haxeko/h2-soil-sensor/hardware/docs/drc_report.txt

** Drc report for /home/user/h2-soil-sensor/hardware/h2-soil-sensor.kicad_pcb **
** Created on 2026-11-12 06:37:23 **

** Found 0 DRC violations **

** Found 0 unconnected pads **

** Found 0 Footprint errors **

** End of Report **
