haxeko/h2-soil-sensor/hardware/docs/render_bottom.png

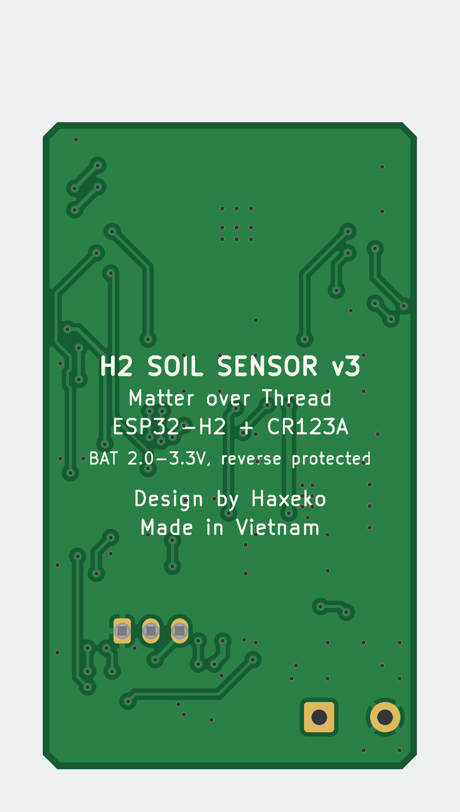
hardware/docs/render_bottom.png
