haxeko/h2-soil-sensor/hardware/docs/render_top.png

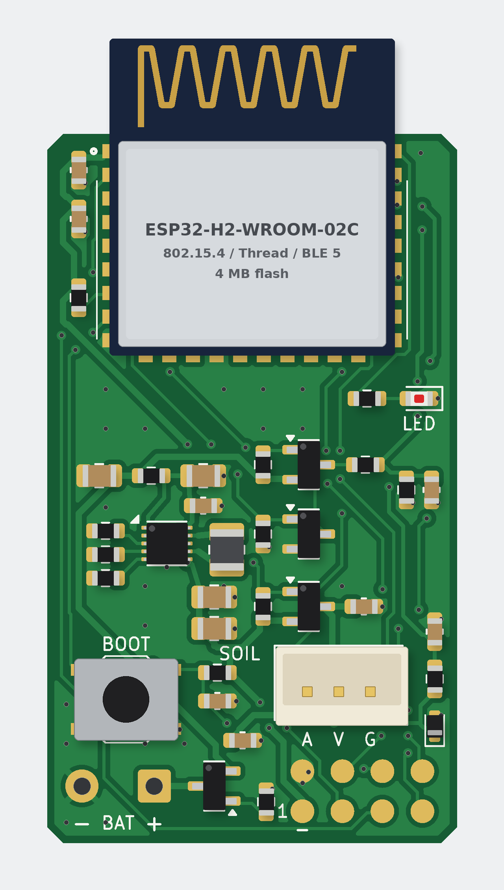
hardware/docs/render_top.png
