haxeko/h2-soil-sensor/hardware/fab/h2-soil-sensor_BOM_JLCPCB.csv

Comment | Designator | Footprint | LCSC Part # | MPN | Manufacturer | Qty
47uF 6.3V | C1 | C_0805_2012Metric | C16780 | CL21A476MQYNNNE | Samsung | 1
10uF 25V | C2 | C_0805_2012Metric | C15850 | CL21A106KAYNNNE | Samsung | 1
100nF | C3,C9,C21 | C_0603_1608Metric | C14663 | CC0603KRX7R9BB104 | YAGEO | 3
22uF 25V | C4,C5 | C_0805_2012Metric | C45783 | CL21A226MAQNNNE | Samsung | 2
10nF | C6,C13 | C_0603_1608Metric | C1589 | CL10B103KB8NNNC | Samsung | 2
1uF | C7,C14 | C_0603_1608Metric | C15849 | CL10A105KB8NNNC | Samsung | 2
10uF 10V | C8 | C_0603_1608Metric | C19702 | CL10A106KP8NNNC | Samsung | 1
RED | D2 | LED_0603_1608Metric | C2286 | KT-0603R | Hubei KENTO | 1
ESD 3.3V | D3 | D_SOD-523 | C136161 | LESD5Z3.3T1G | LRC | 1
2.2uH | L1 | L_1008_2520Metric | C404804 | TFM252012ALMA2R2MTAA | TDK | 1
AO3415A | Q1 | SOT-23 | C133233 | AO3415A | AOS | 1
AO3401A | Q2,Q4 | SOT-23 | C15127 | AO3401A | AOS | 2
2N7002 | Q3 | SOT-23 | C8545 | 2N7002 | CJ | 1
100k | R1,R6,R7,R8,R9 | R_0603_1608Metric | C25803 | 0603WAF1003T5E | UNI-ROYAL | 5
36.5k | R2 | R_0603_1608Metric | C23029 | 0603WAF3652T5E | UNI-ROYAL | 1
0R | R3,R10 | R_0603_1608Metric | C21189 | 0603WAF0000T5E | UNI-ROYAL | 2
16.2k | R4 | R_0603_1608Metric | C22885 | 0603WAF1622T5E | UNI-ROYAL | 1
1M | R5 | R_0603_1608Metric | C22935 | 0603WAF1004T5E | UNI-ROYAL | 1
10k | R11,R21 | R_0603_1608Metric | C25804 | 0603WAF1002T5E | UNI-ROYAL | 2
1k | R12,R22 | R_0603_1608Metric | C21190 | 0603WAF1001T5E | UNI-ROYAL | 2
BOOT/USER | SW1 | SW_Push_1P1T_XKB_TS-1187A | C318884 | TS-1187A-B-A-B | XKB | 1
TPS63900DSKR | U1 | WSON-10-1EP_2.5x2.5mm_P0.5mm_EP1.2x2mm_ThermalVias_0.3mm | C1518762 | TPS63900DSKR | Texas Instruments | 1
