haxeko/h2-soil-sensor/hardware/fab/h2-soil-sensor_not_assembled.csv

Designator | Value | Reason
J1 | PROG | khong lap (pad/lo/test point)
J3 | BAT (pads) | khong lap (pad/lo/test point)
J4 | SOIL (PH2.0) | THT - han tay (C131339)
U2 | ESP32-H2-WROOM-02C-H4S | module ESP32-H2 - han tay / dat rieng
