haxeko/h2-soil-sensor/hardware/docs/schematic.pdf

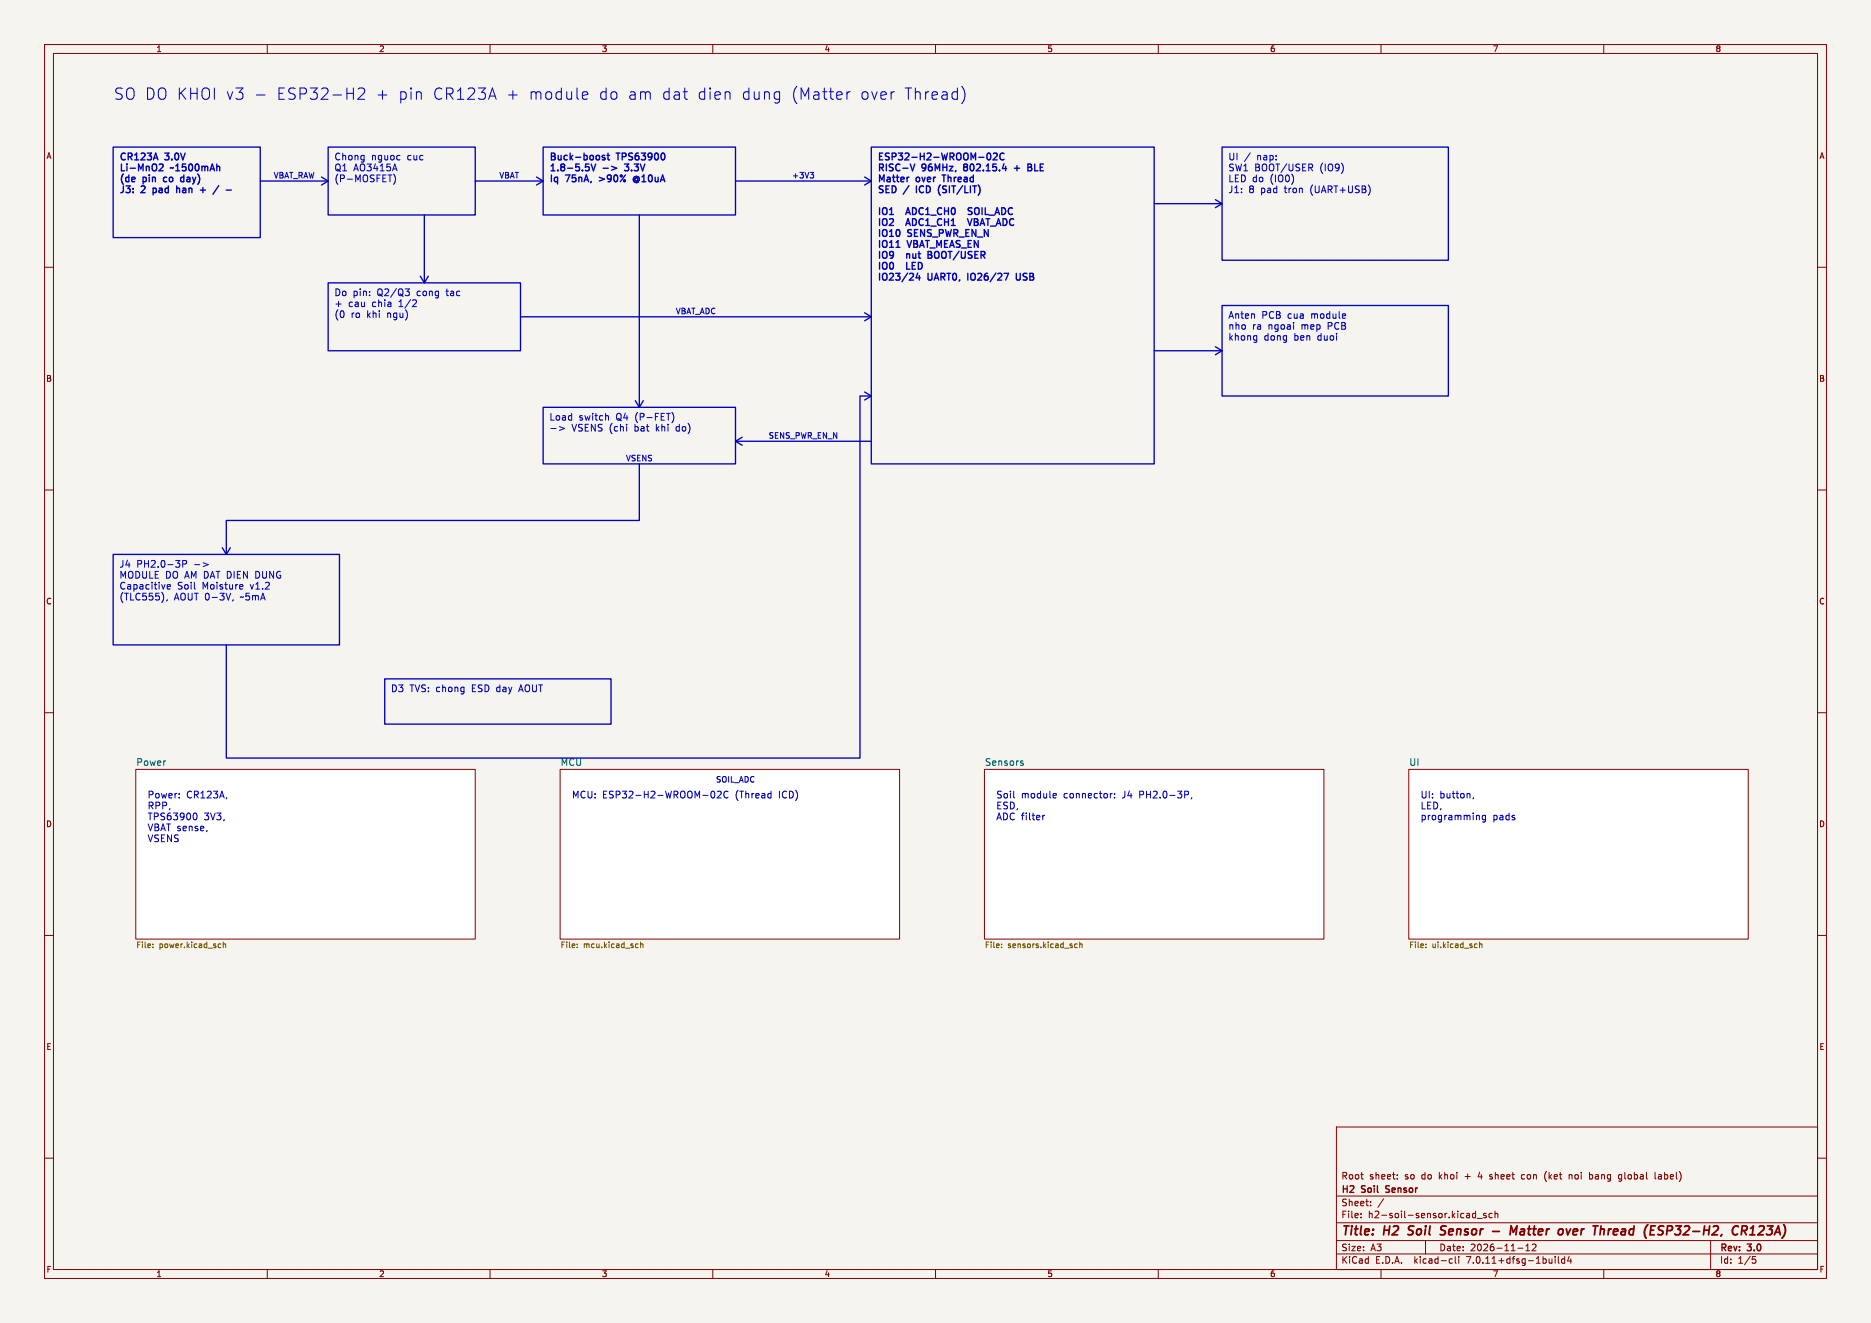
[picture p6: page 1]

UI / nap: SW1 BOOT/USER (IO9) LED do (IO0) J1: 8 pad tron (UART+USB) Anten PCB cua module

Do pin: Q2/Q3 cong tac + cau chia 1/2

nho ra ngoai mep PCB
khong dong ben duoi

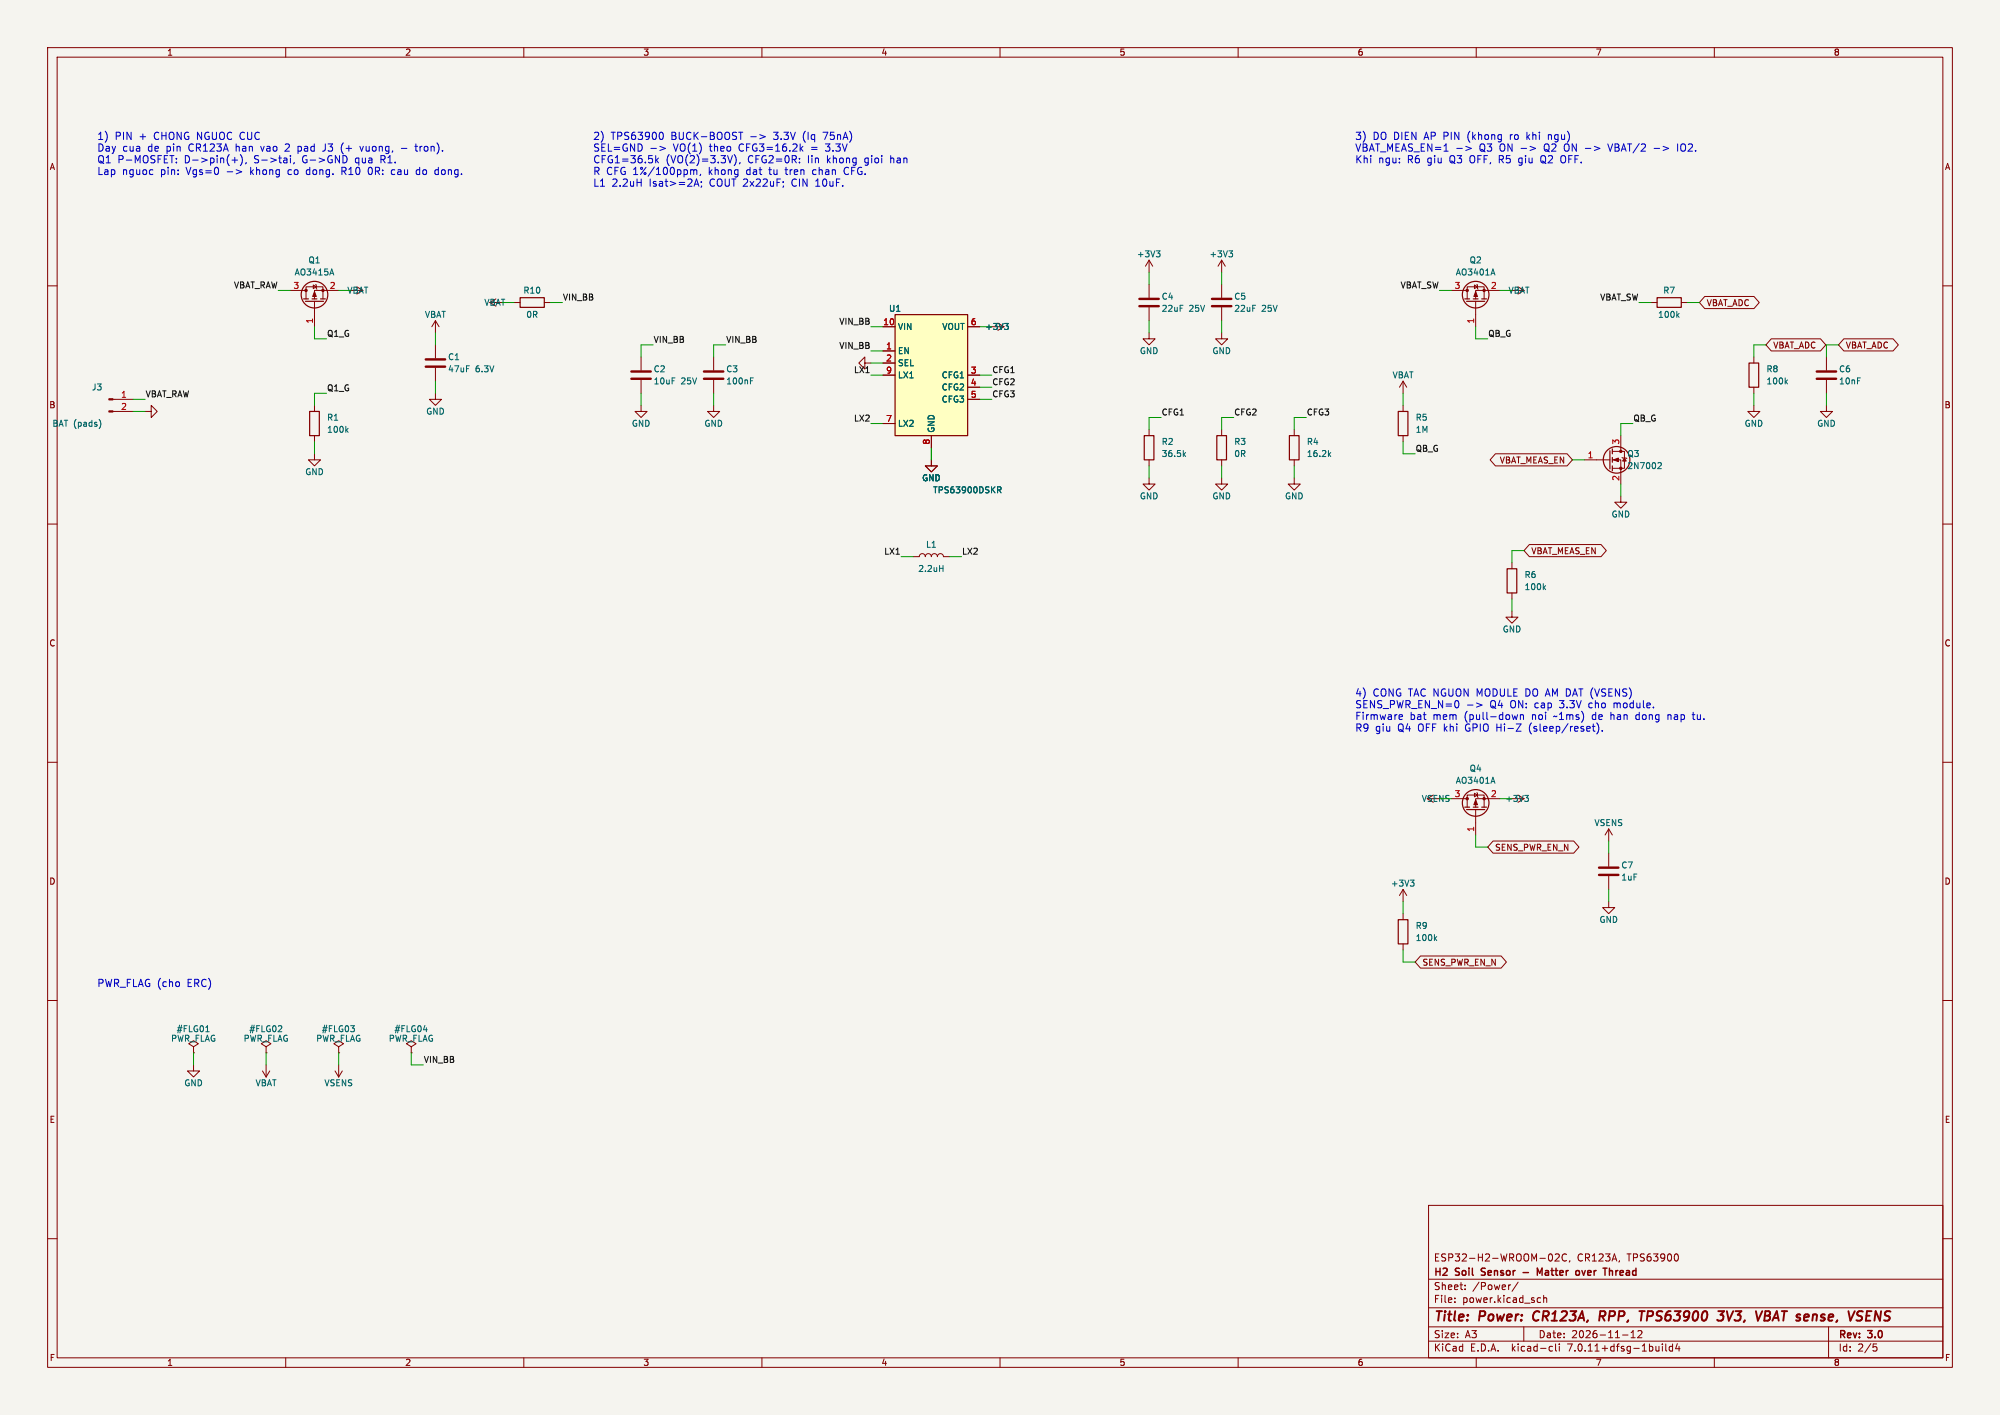
[picture p7: page 2]

Day cua de pin CR123A han vao 2 pad J3 (+ vuong, - tron).

3) DO DIEN AP PIN (khong ro khi ngu)

4) CONG TAC NGUON MODULE DO AM DAT (VSENS)

Id: 2/5 Title: Power: CR123A, RPP, TPS63900 3V3, VBAT sense, VSENS

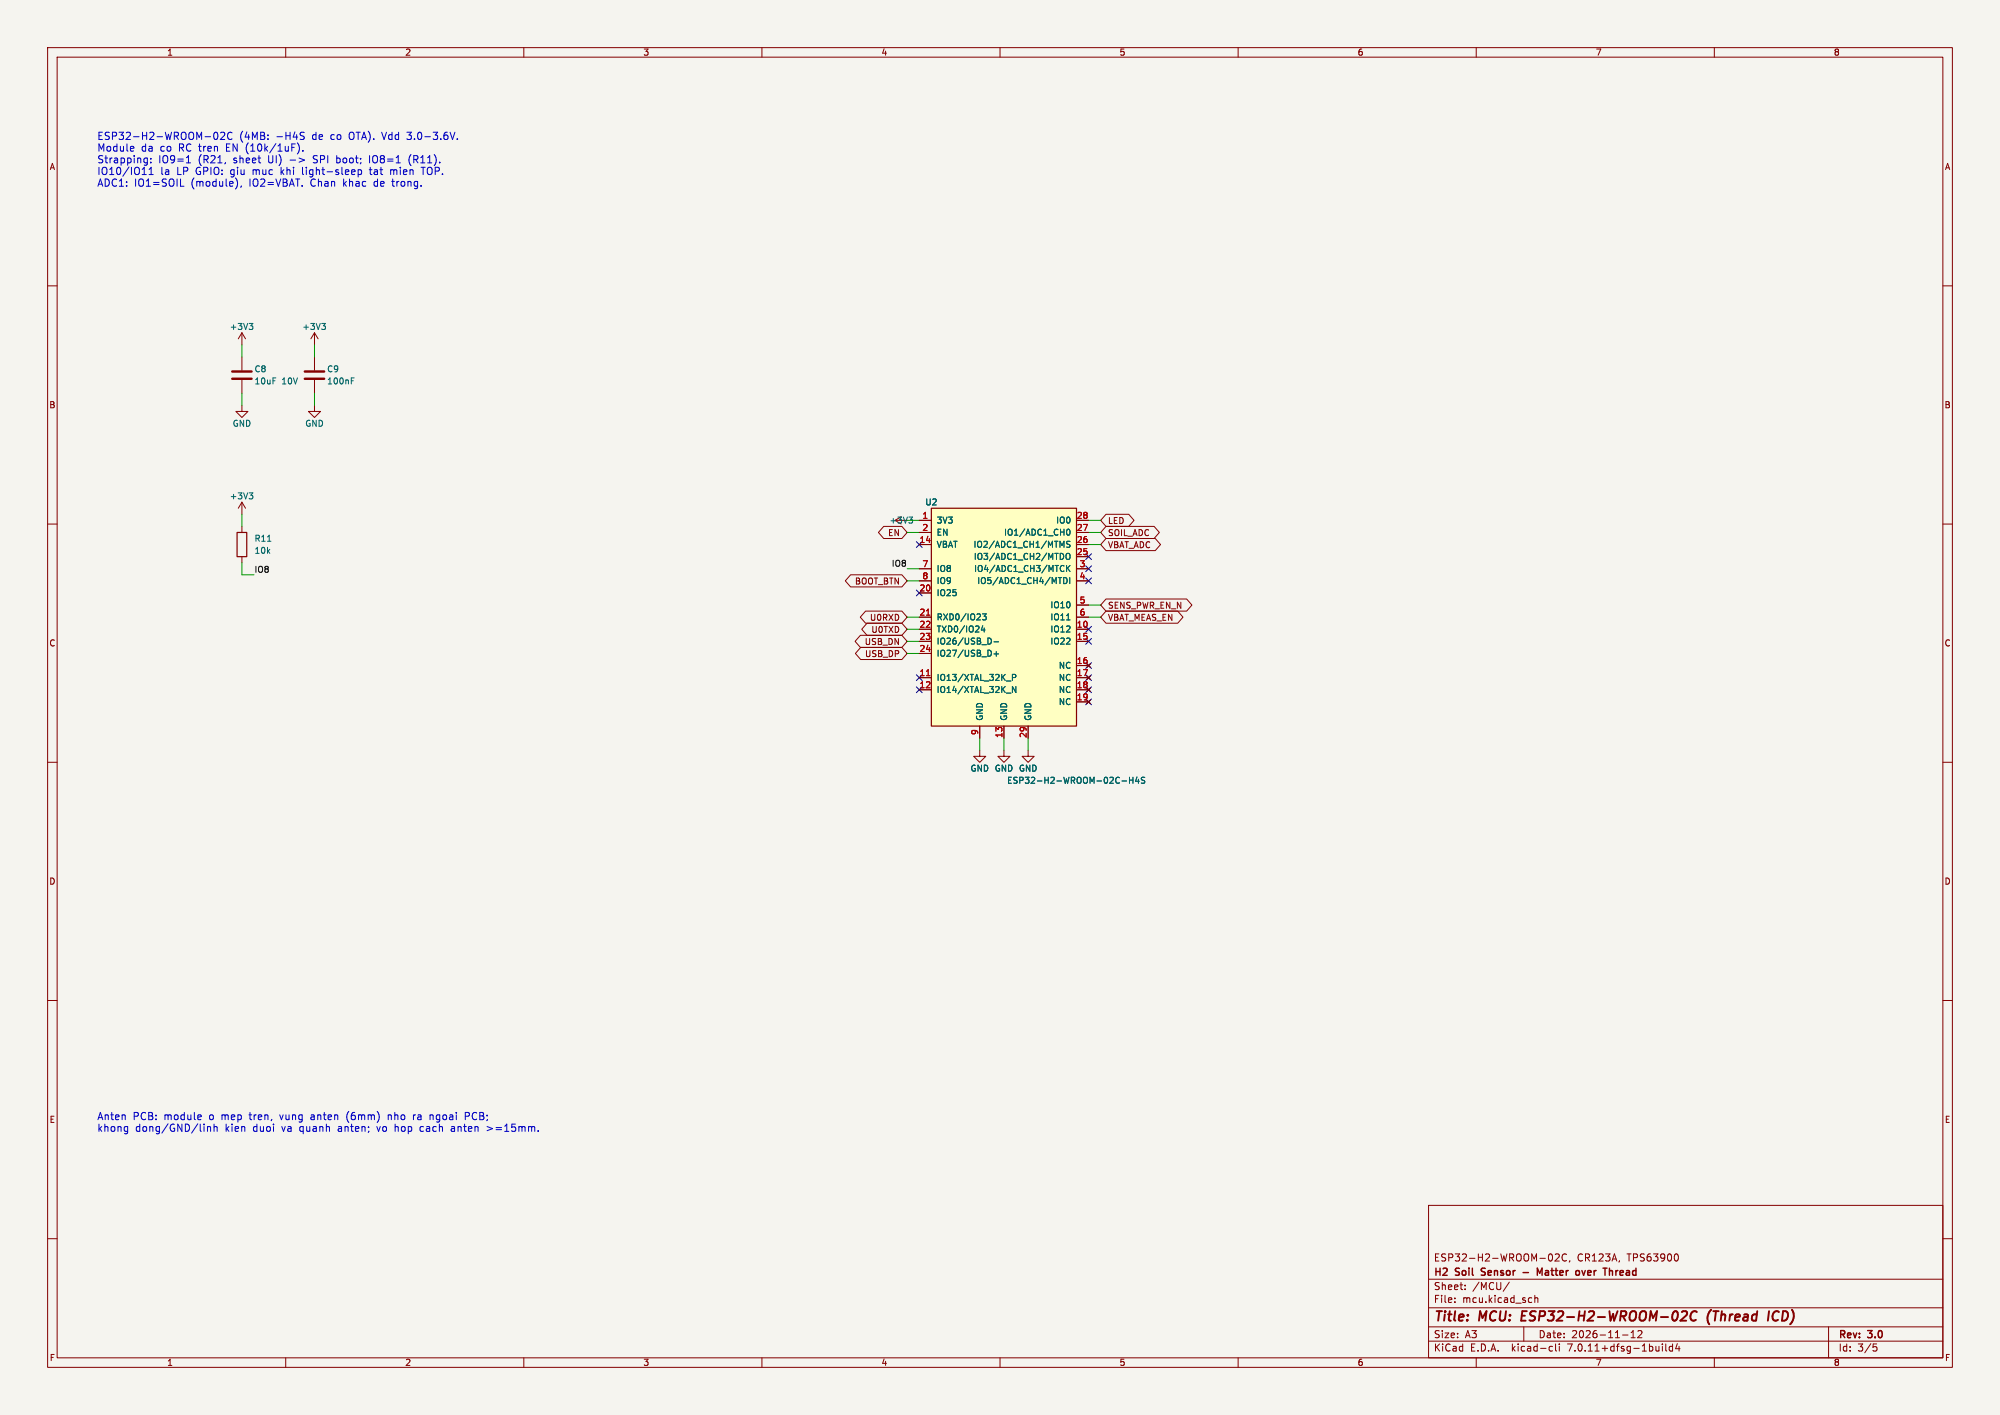
[picture p8: page 3]

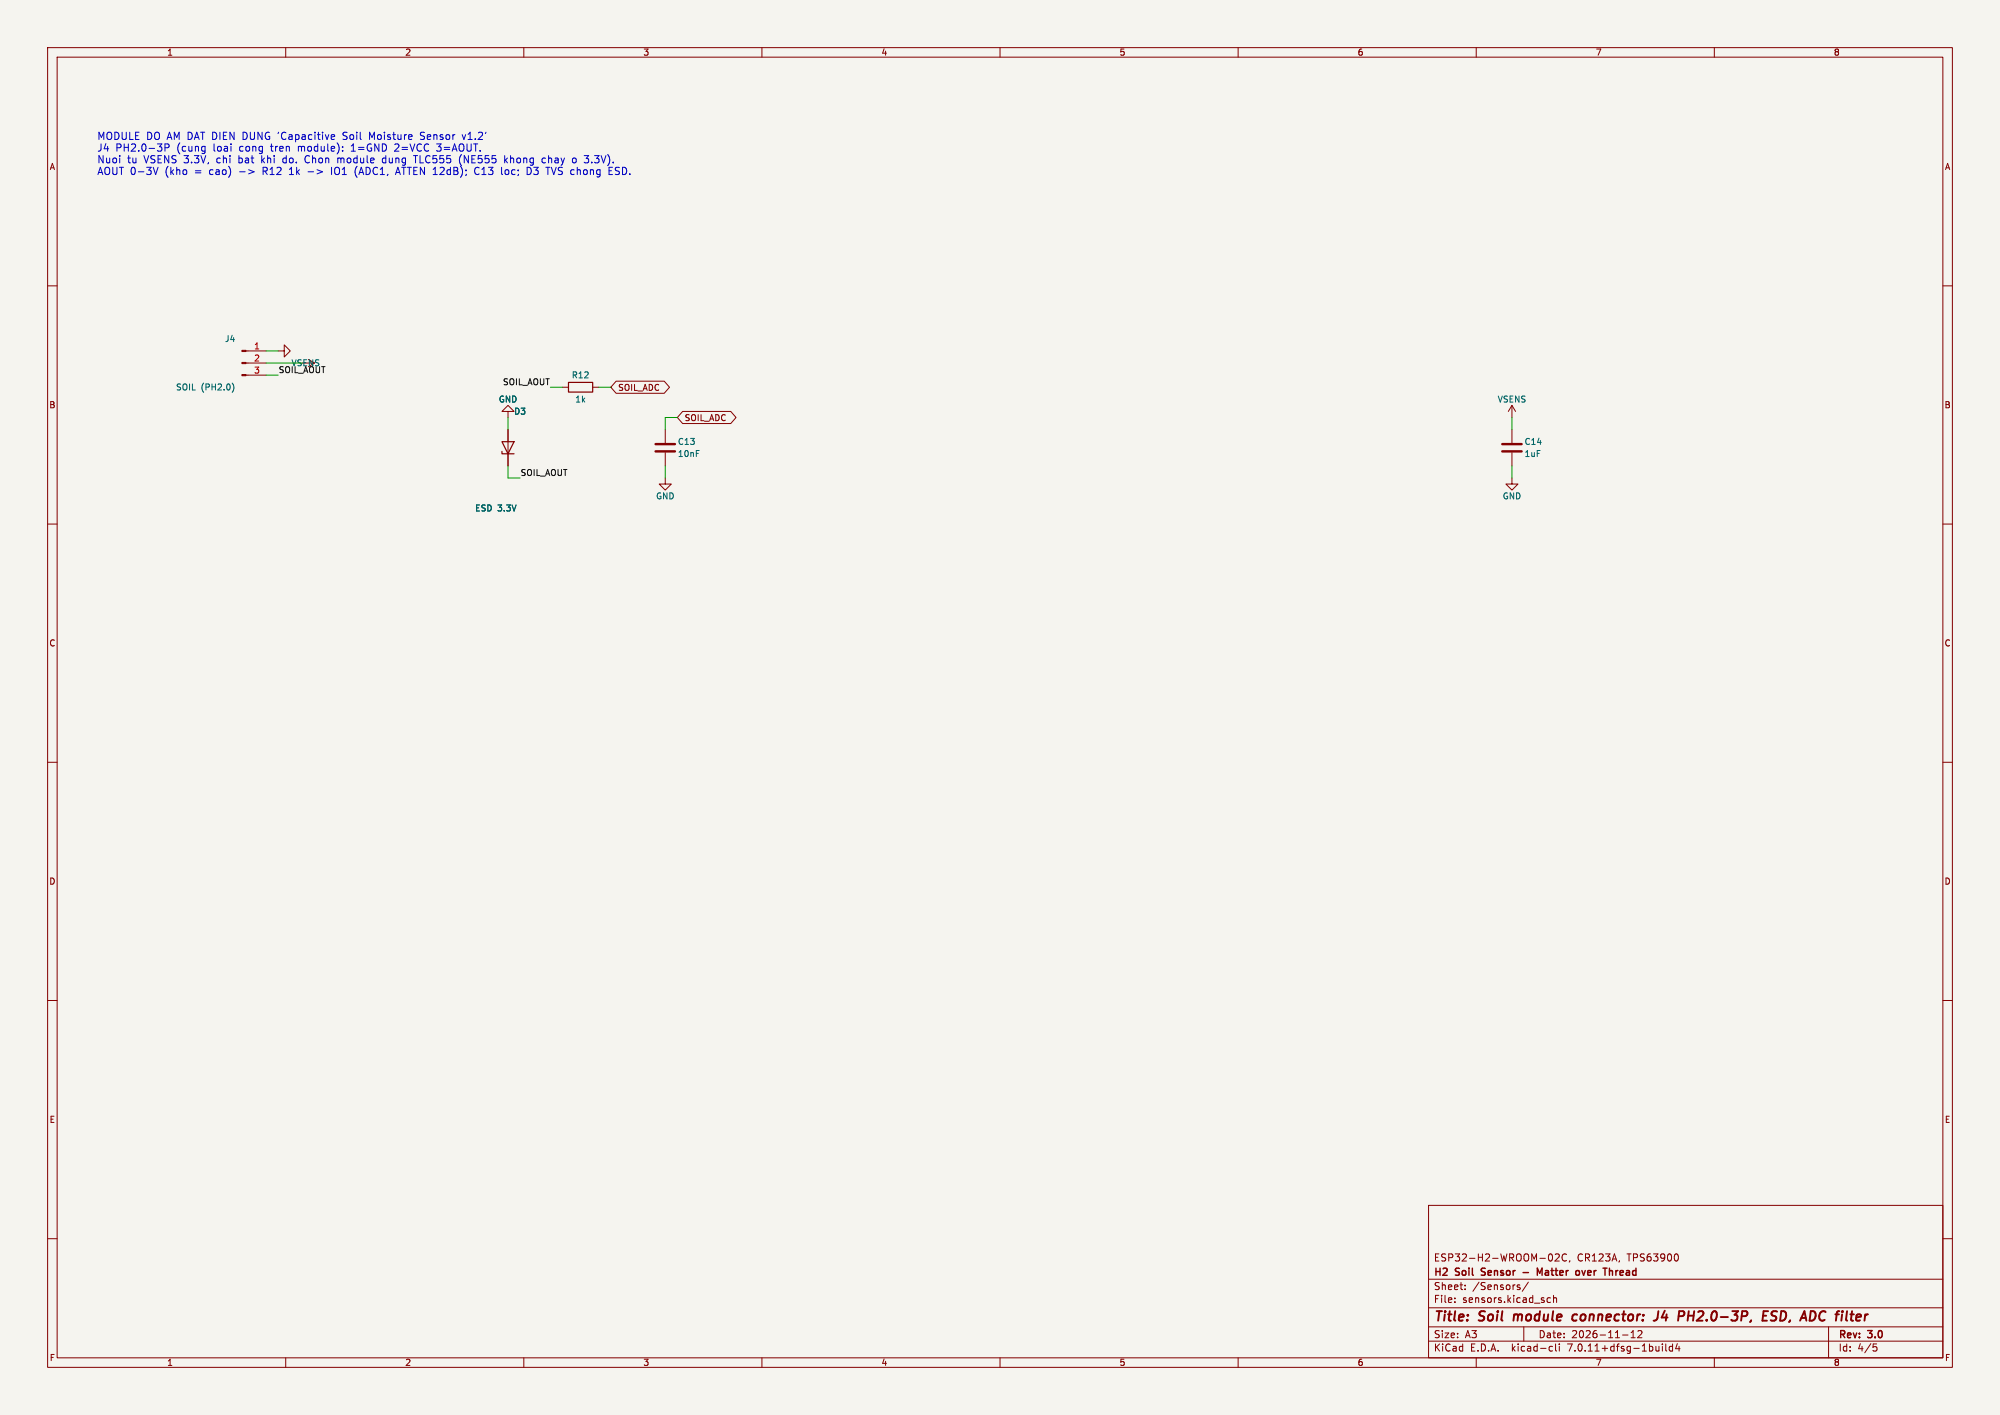
[picture p9: page 4]

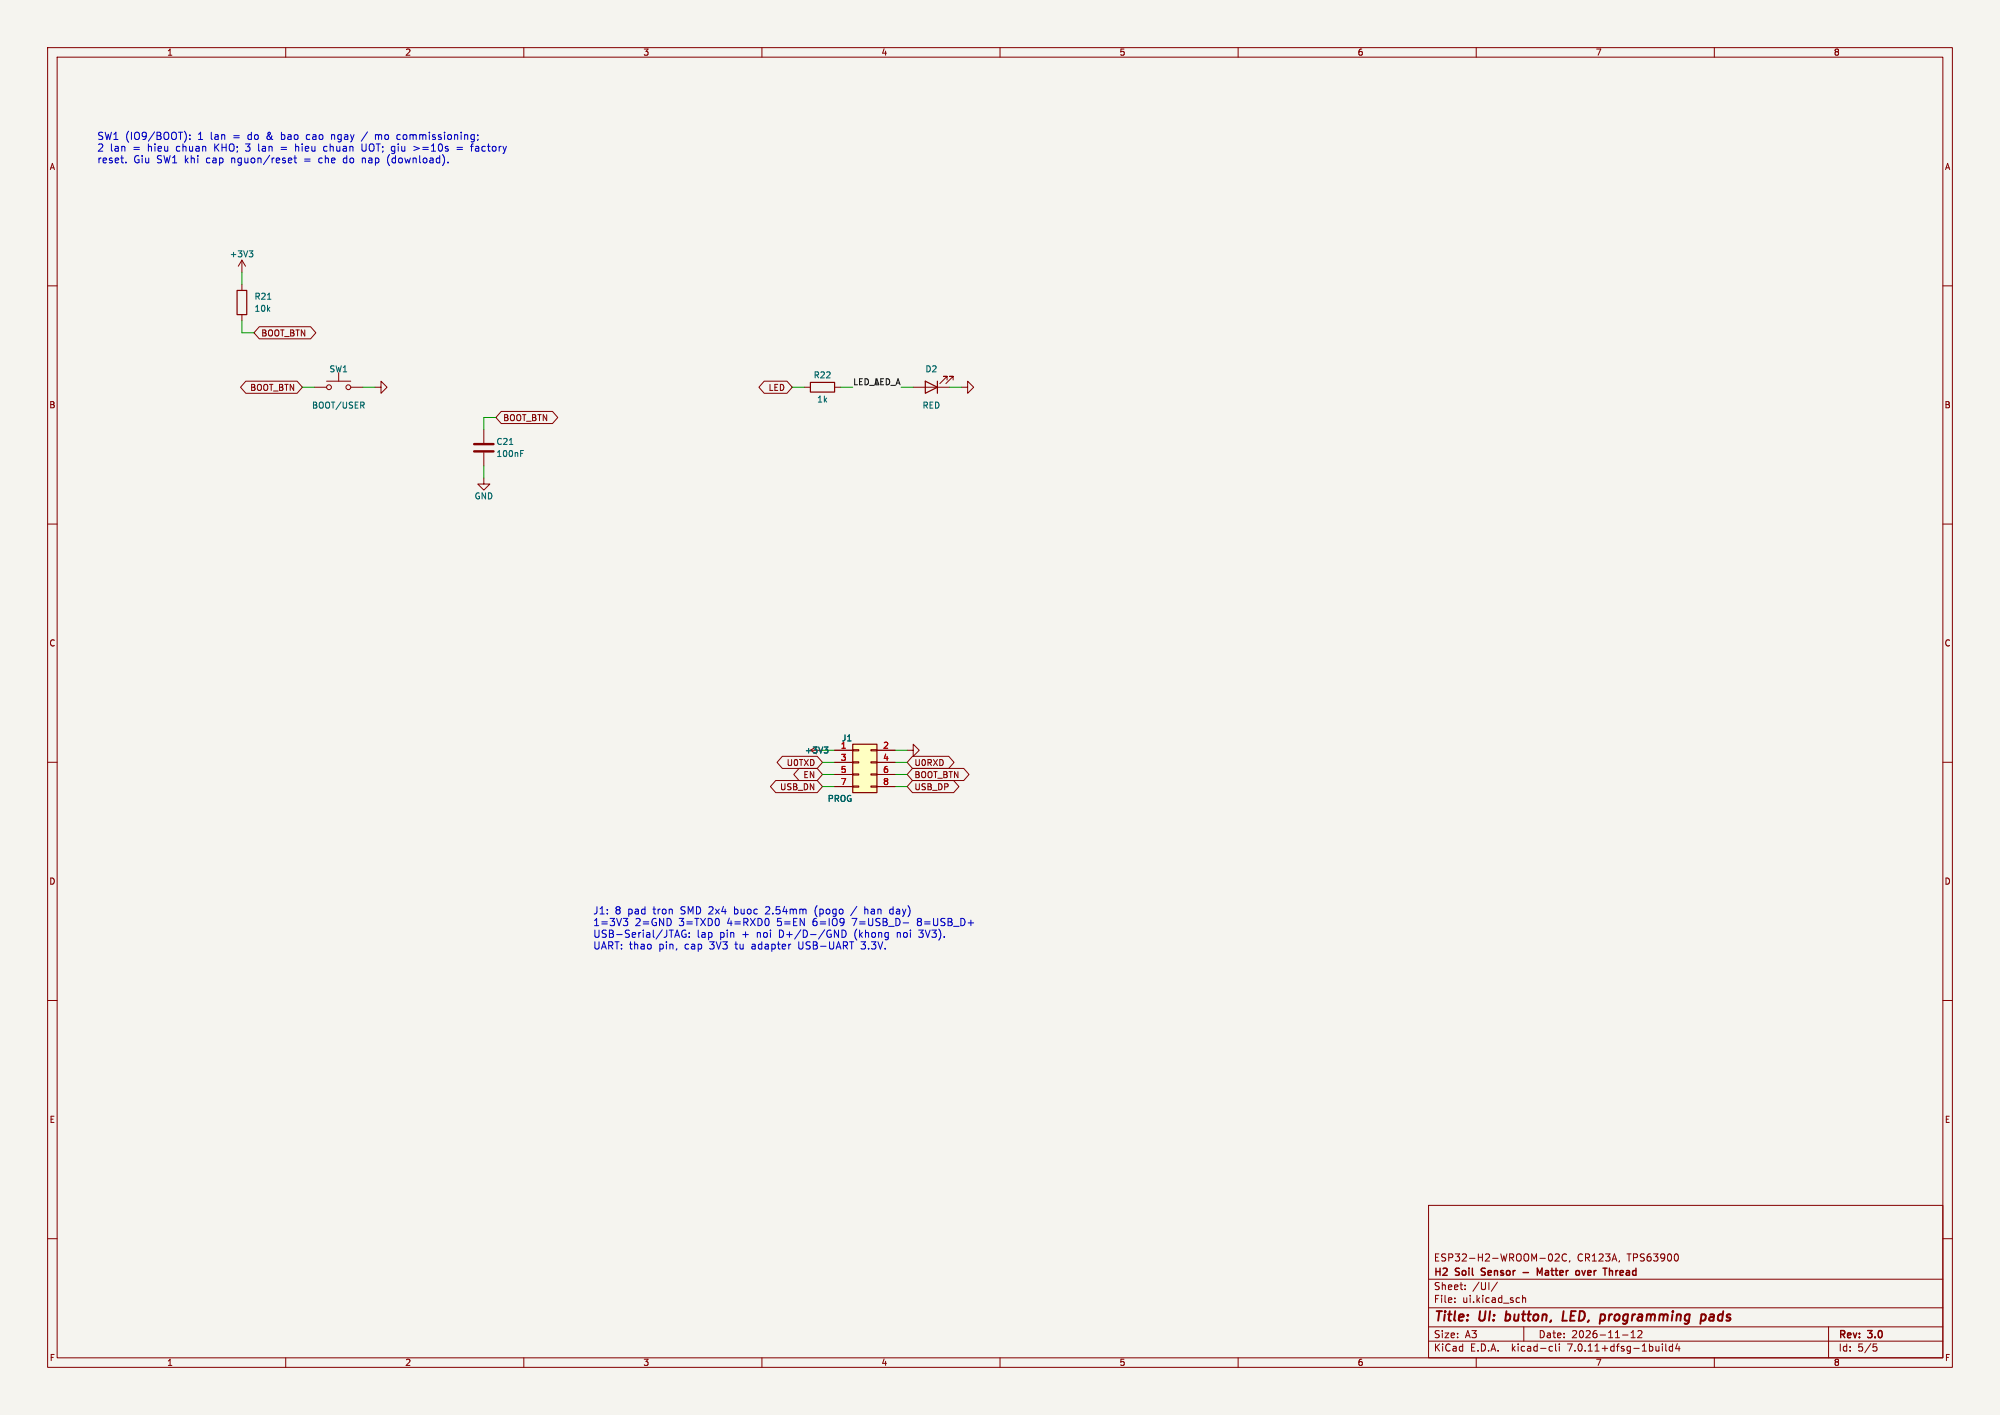
[picture p10: page 5]

Id: 5/5 Title: UI: button, LED, programming pads
