haxeko/h2-soil-sensor/hardware/docs/assembly_top.pdf

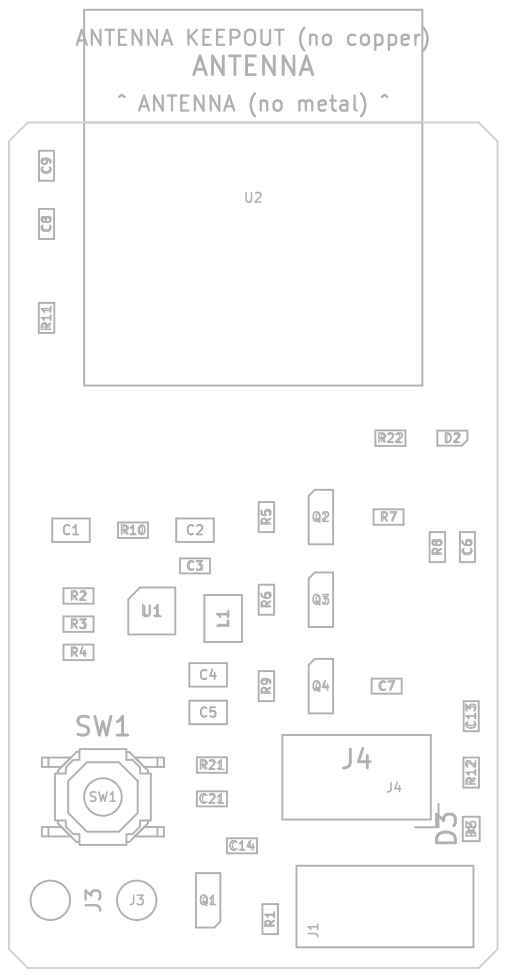
[picture p11: page 1]
