haxeko/h2-soil-sensor/hardware/docs/pcb_bottom.pdf

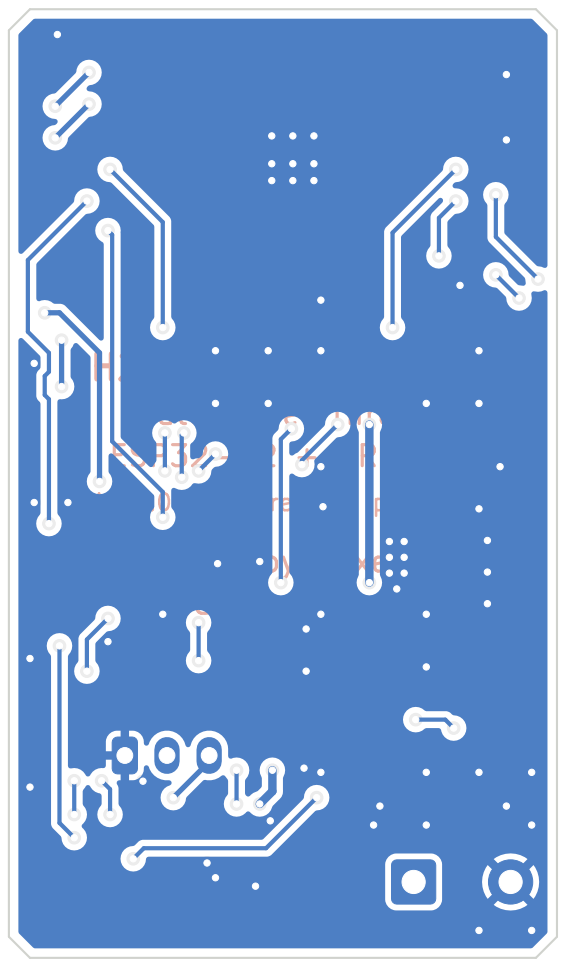
[picture p12: page 1]
