haxeko/h2-soil-sensor/hardware/docs/pcb_top.pdf

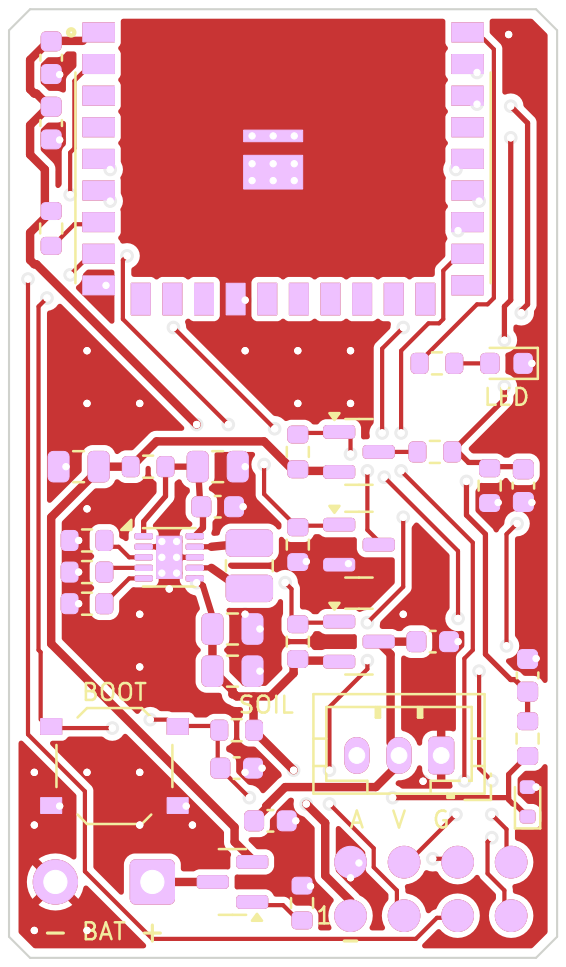
[picture p13: page 1]
