haxeko/h2-soil-sensor/hardware/h2-soil-sensor.kicad_pcb

## KiCad design hardware/h2-soil-sensor.kicad_pcb (2026-11-12)

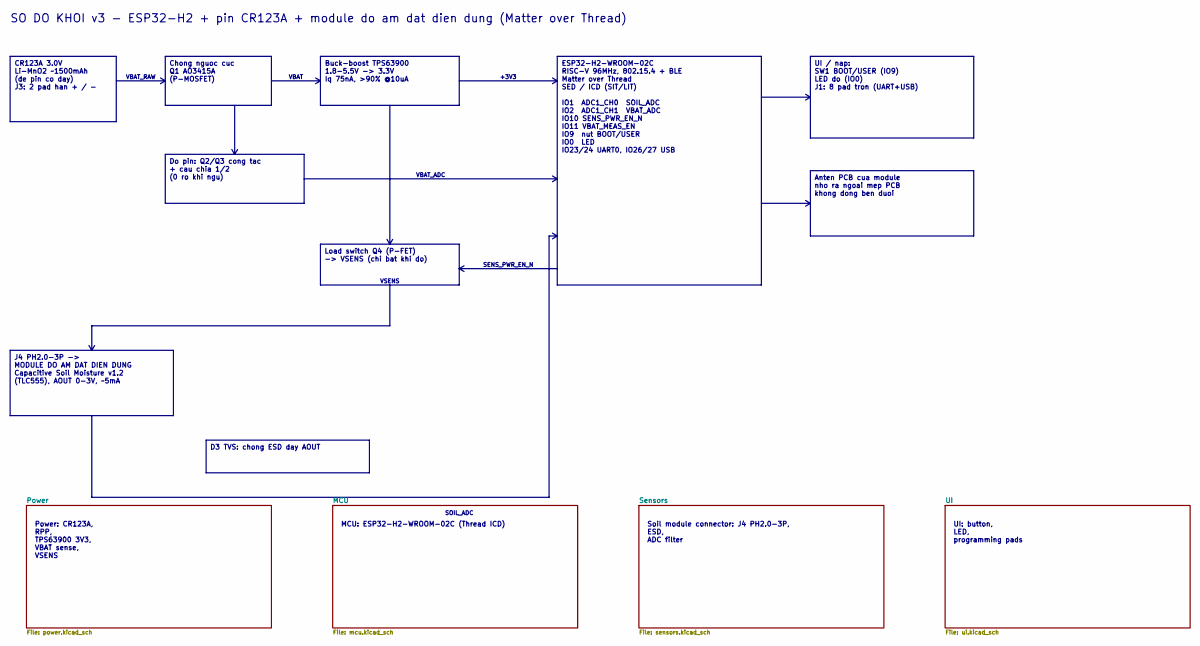
[picture p14: schematic h2-soil-sensor.kicad_sch, H2 Soil Sensor - Matter over Thread (ESP32-H2, CR123A)]

Notes on the sheet:
Power: CR123A, RPP, TPS63900 3V3, VBAT sense, VSENS
MCU: ESP32-H2-WROOM-02C (Thread ICD)
Soil module connector: J4 PH2.0-3P, ESD, ADC filter
UI: button, LED, programming pads
SO DO KHOI v3 - ESP32-H2 + pin CR123A + module do am dat dien dung (Matter over Thread)
CR123A 3.0V Li-MnO2 ~1500mAh (de pin co day) J3: 2 pad han + / -
Chong nguoc cuc Q1 AO3415A (P-MOSFET)
Buck-boost TPS63900 1.8-5.5V -> 3.3V Iq 75nA, >90% @10uA
ESP32-H2-WROOM-02C RISC-V 96MHz, 802.15.4 + BLE Matter over Thread SED / ICD (SIT/LIT) IO1 ADC1_CH0 SOIL_ADC IO2 ADC1_CH1 VBAT_ADC IO10 SENS_PWR_EN_N IO11 VBAT_MEAS_EN IO9 nut BOOT/USER IO0 LED IO23/24 UART0, IO26/27 USB
Do pin: Q2/Q3 cong tac + cau chia 1/2 (0 ro khi ngu)
Load switch Q4 (P-FET) -> VSENS (chi bat khi do)
J4 PH2.0-3P -> MODULE DO AM DAT DIEN DUNG Capacitive Soil Moisture v1.2 (TLC555), AOUT 0-3V, ~5mA
D3 TVS: chong ESD day AOUT
UI / nap: SW1 BOOT/USER (IO9) LED do (IO0) J1: 8 pad tron (UART+USB)
Anten PCB cua module nho ra ngoai mep PCB khong dong ben duoi
VBAT_RAW
VBAT
+3V3
VBAT_ADC
SENS_PWR_EN_N
VSENS
SOIL_ADC

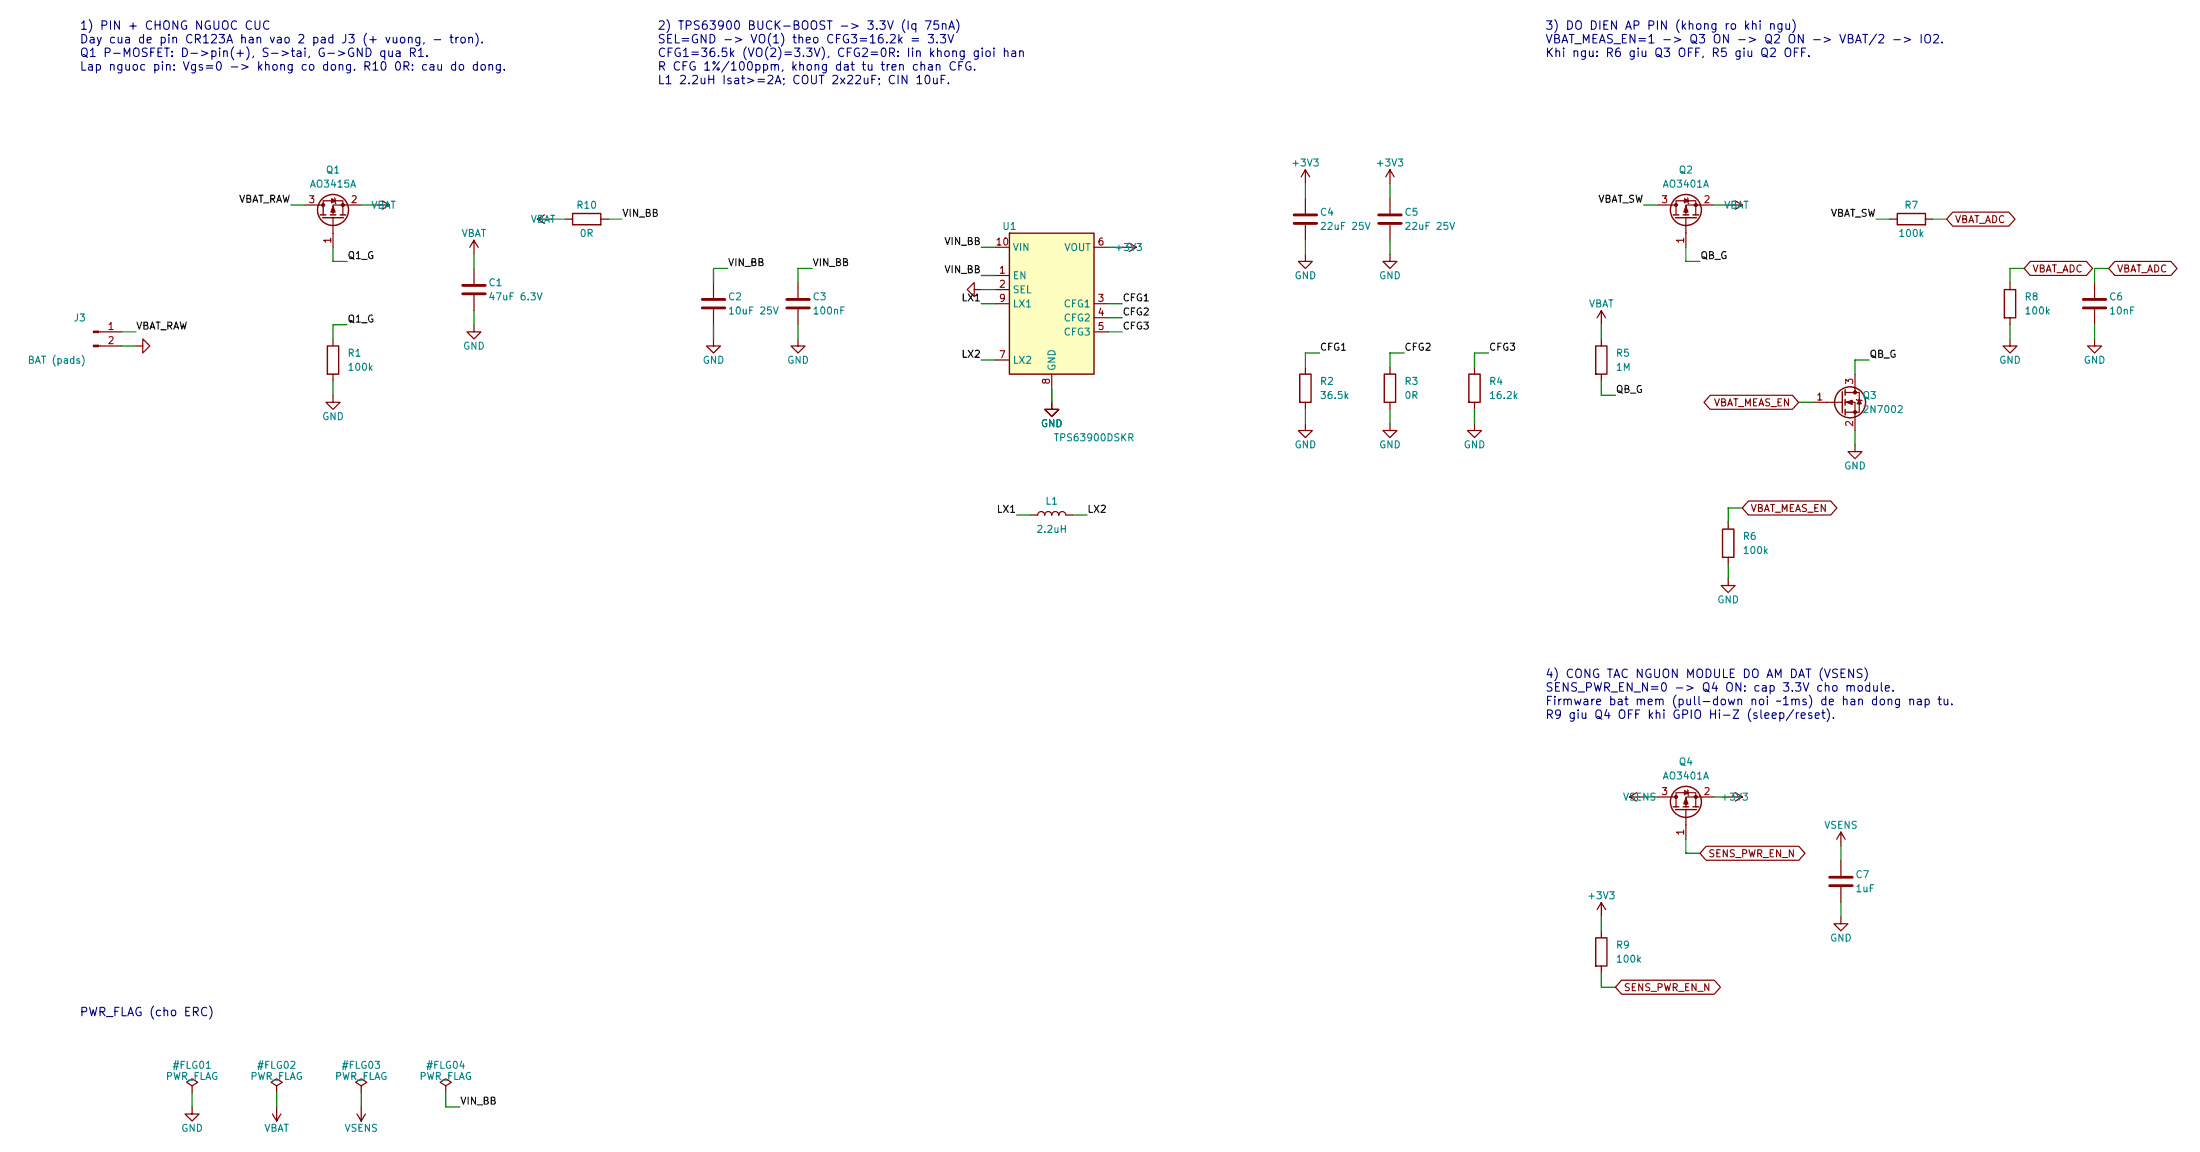
[picture p15: schematic power.kicad_sch, Power: CR123A, RPP, TPS63900 3V3, VBAT sense, VSENS]

Parts:
C1: 47uF 6.3V; C_0805_2012Metric; MPN CL21A476MQYNNNE; LCSC C16780
C2: 10uF 25V; C_0805_2012Metric; MPN CL21A106KAYNNNE; LCSC C15850
C3: 100nF; C_0603_1608Metric; MPN CC0603KRX7R9BB104; LCSC C14663
C4, C5: 22uF 25V; C_0805_2012Metric; MPN CL21A226MAQNNNE; LCSC C45783
C6: 10nF; C_0603_1608Metric; MPN CL10B103KB8NNNC; LCSC C1589
C7: 1uF; C_0603_1608Metric; MPN CL10A105KB8NNNC; LCSC C15849
J3: BAT (pads); SolderWire-0.5sqmm_1x02_P4.6mm_D0.9mm_OD2.1mm
L1: 2.2uH; L_1008_2520Metric; MPN TFM252012ALMA2R2MTAA; LCSC C404804
Q1: AO3415A; SOT-23; MPN AO3415A; LCSC C133233
Q2, Q4: AO3401A; SOT-23; MPN AO3401A; LCSC C15127
Q3: 2N7002; SOT-23; MPN 2N7002; LCSC C8545
R1, R6, R7, R8, R9: 100k; R_0603_1608Metric; MPN 0603WAF1003T5E; LCSC C25803
R2: 36.5k; R_0603_1608Metric; MPN 0603WAF3652T5E; LCSC C23029
R3, R10: 0R; R_0603_1608Metric; MPN 0603WAF0000T5E; LCSC C21189
R4: 16.2k; R_0603_1608Metric; MPN 0603WAF1622T5E; LCSC C22885
R5: 1M; R_0603_1608Metric; MPN 0603WAF1004T5E; LCSC C22935
U1: TPS63900DSKR; WSON-10-1EP_2.5x2.5mm_P0.5mm_EP1.2x2mm_ThermalVias_0.3mm; MPN TPS63900DSKR; LCSC C1518762

Connections:
+3V3: C4.1, C5.1, Q4.2 (S), R9.1, U1.6 (VOUT); also elsewhere on the board
CFG1: R2.1, U1.3 (CFG1)
CFG2: R3.1, U1.4 (CFG2)
CFG3: R4.1, U1.5 (CFG3)
GND: C1.2, C2.2, C3.2, C4.2, C5.2, C6.2, C7.2, J3.2, Q3.2 (S), R1.2, R2.2, R3.2, R4.2, R6.2, R8.2, U1.2 (SEL), U1.8 (GND), U1.11 (GND); also elsewhere on the board
LX1: L1.1, U1.9 (LX1)
LX2: L1.2, U1.7 (LX2)
Q1_G: Q1.1 (G), R1.1
QB_G: Q2.1 (G), Q3.3 (D), R5.2
SENS_PWR_EN_N: Q4.1 (G), R9.2; also elsewhere on the board
VBAT: C1.1, Q1.2 (S), Q2.2 (S), R5.1, R10.1
VBAT_ADC: C6.1, R7.2, R8.1; also elsewhere on the board
VBAT_MEAS_EN: Q3.1 (G), R6.1; also elsewhere on the board
VBAT_RAW: J3.1, Q1.3 (D)
VBAT_SW: Q2.3 (D), R7.1
VIN_BB: C2.1, C3.1, R10.2, U1.1 (EN), U1.10 (VIN)
VSENS: C7.1, Q4.3 (D); also elsewhere on the board

Notes on the sheet:
1) PIN + CHONG NGUOC CUC Day cua de pin CR123A han vao 2 pad J3 (+ vuong, - tron). Q1 P-MOSFET: D->pin(+), S->tai, G->GND qua R1. Lap nguoc pin: Vgs=0 -> khong co dong. R10 0R: cau do dong.
2) TPS63900 BUCK-BOOST -> 3.3V (Iq 75nA) SEL=GND -> VO(1) theo CFG3=16.2k = 3.3V CFG1=36.5k (VO(2)=3.3V), CFG2=0R: Iin khong gioi han R CFG 1%/100ppm, khong dat tu tren chan CFG. L1 2.2uH Isat>=2A; COUT 2x22uF; CIN 10uF.
3) DO DIEN AP PIN (khong ro khi ngu) VBAT_MEAS_EN=1 -> Q3 ON -> Q2 ON -> VBAT/2 -> IO2. Khi ngu: R6 giu Q3 OFF, R5 giu Q2 OFF.
4) CONG TAC NGUON MODULE DO AM DAT (VSENS) SENS_PWR_EN_N=0 -> Q4 ON: cap 3.3V cho module. Firmware bat mem (pull-down noi ~1ms) de han dong nap tu. R9 giu Q4 OFF khi GPIO Hi-Z (sleep/reset).
PWR_FLAG (cho ERC)

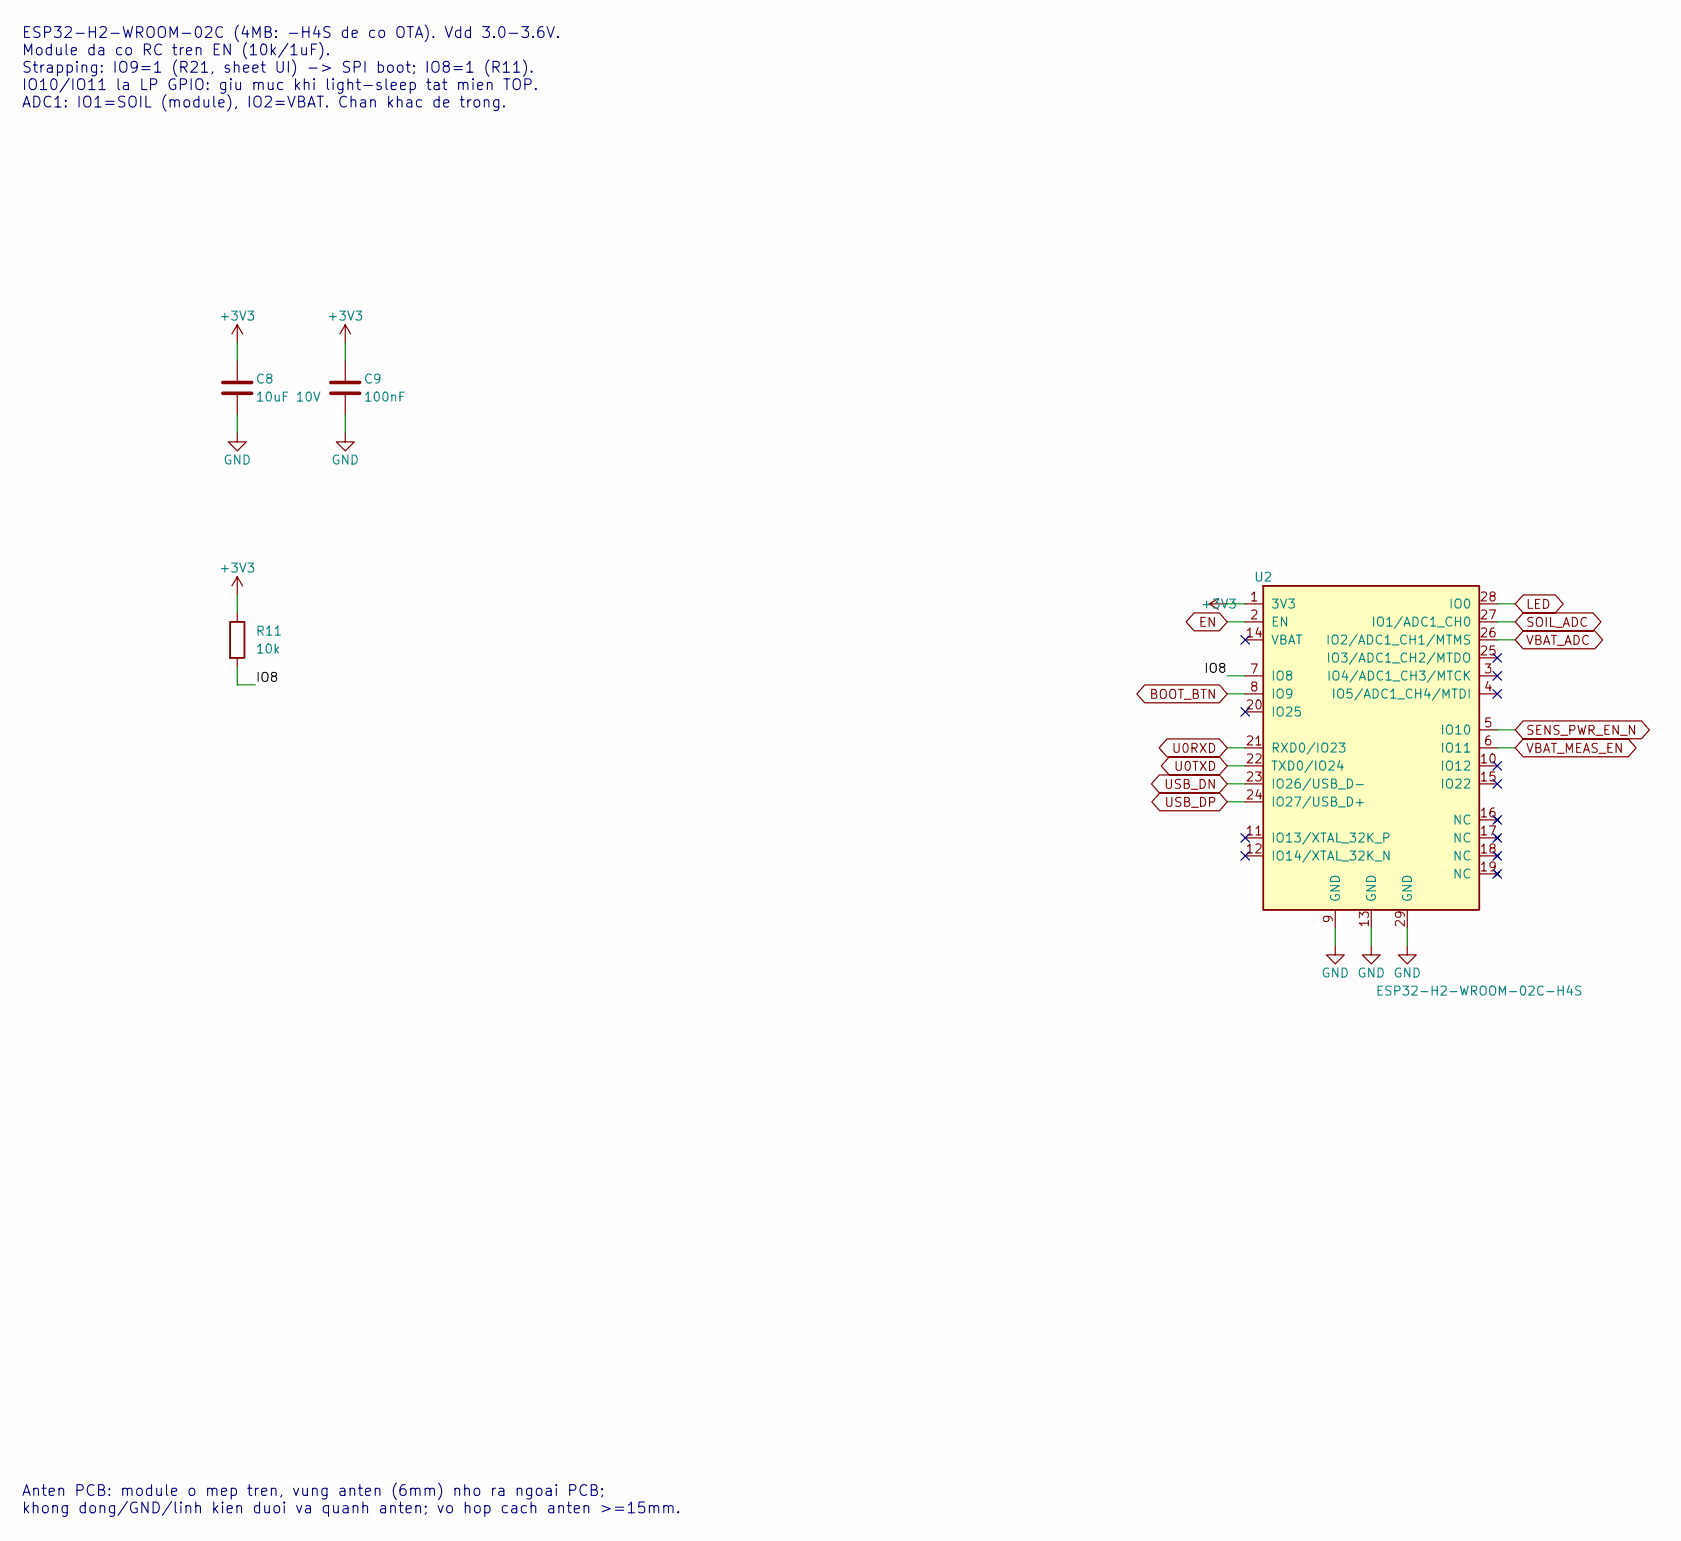
[picture p16: schematic mcu.kicad_sch, MCU: ESP32-H2-WROOM-02C (Thread ICD)]

Parts:
C8: 10uF 10V; C_0603_1608Metric; MPN CL10A106KP8NNNC; LCSC C19702
C9: 100nF; C_0603_1608Metric; MPN CC0603KRX7R9BB104; LCSC C14663
R11: 10k; R_0603_1608Metric; MPN 0603WAF1002T5E; LCSC C25804
U2: ESP32-H2-WROOM-02C-H4S; ESP32-H2-WROOM-02C; MPN ESP32-H2-WROOM-02C-H4S

Connections:
+3V3: C8.1, C9.1, R11.1, U2.1 (3V3); also elsewhere on the board
BOOT_BTN: U2.8 (IO9); also elsewhere on the board
EN: U2.2 (EN); also elsewhere on the board
GND: C8.2, C9.2, U2.9 (GND), U2.13 (GND), U2.29 (GND); also elsewhere on the board
IO8: R11.2, U2.7 (IO8)
LED: U2.28 (IO0); also elsewhere on the board
SENS_PWR_EN_N: U2.5 (IO10); also elsewhere on the board
SOIL_ADC: U2.27 (IO1/ADC1_CH0); also elsewhere on the board
U0RXD: U2.21 (RXD0/IO23); also elsewhere on the board
U0TXD: U2.22 (TXD0/IO24); also elsewhere on the board
USB_DN: U2.23 (IO26/USB_D-); also elsewhere on the board
USB_DP: U2.24 (IO27/USB_D+); also elsewhere on the board
VBAT_ADC: U2.26 (IO2/ADC1_CH1/MTMS); also elsewhere on the board
VBAT_MEAS_EN: U2.6 (IO11); also elsewhere on the board

Notes on the sheet:
ESP32-H2-WROOM-02C (4MB: -H4S de co OTA). Vdd 3.0-3.6V. Module da co RC tren EN (10k/1uF). Strapping: IO9=1 (R21, sheet UI) -> SPI boot; IO8=1 (R11). IO10/IO11 la LP GPIO: giu muc khi light-sleep tat mien TOP. ADC1: IO1=SOIL (module), IO2=VBAT. Chan khac de trong.
Anten PCB: module o mep tren, vung anten (6mm) nho ra ngoai PCB; khong dong/GND/linh kien duoi va quanh anten; vo hop cach anten >=15mm.

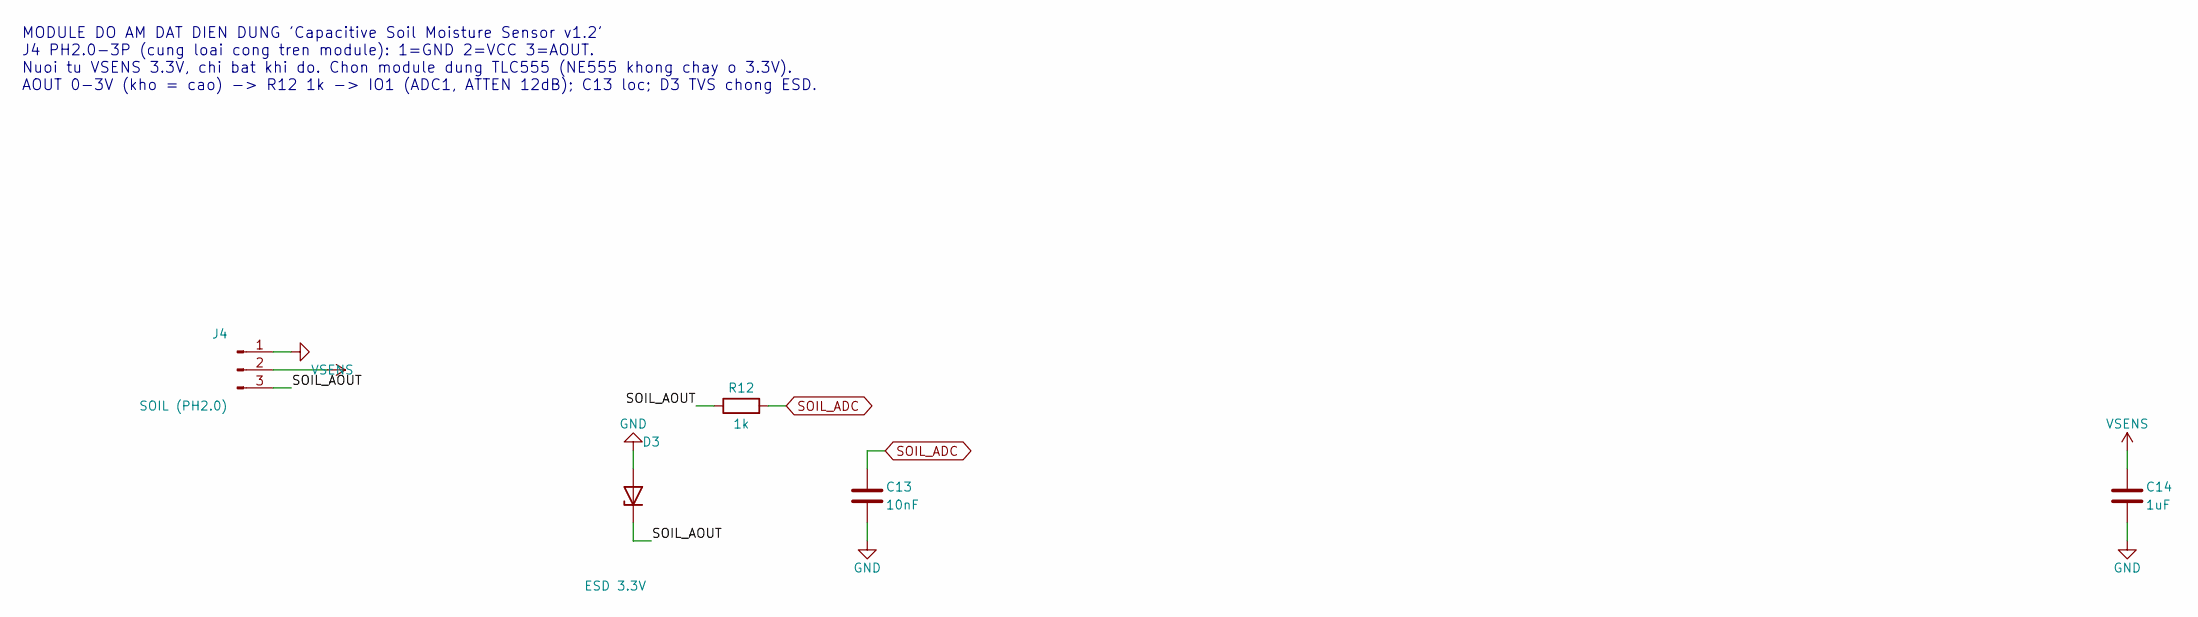
[picture p17: schematic sensors.kicad_sch, Soil module connector: J4 PH2.0-3P, ESD, ADC filter]

Parts:
C13: 10nF; C_0603_1608Metric; MPN CL10B103KB8NNNC; LCSC C1589
C14: 1uF; C_0603_1608Metric; MPN CL10A105KB8NNNC; LCSC C15849
D3: ESD 3.3V; D_SOD-523; MPN LESD5Z3.3T1G; LCSC C136161
J4: SOIL (PH2.0); JST_PH_B3B-PH-K_1x03_P2.00mm_Vertical; MPN B3B-PH-K-S(LF)(SN); LCSC C131339
R12: 1k; R_0603_1608Metric; MPN 0603WAF1001T5E; LCSC C21190

Connections:
GND: C13.2, C14.2, D3.2 (A), J4.1; also elsewhere on the board
SOIL_ADC: C13.1, R12.2; also elsewhere on the board
SOIL_AOUT: D3.1 (K), J4.3, R12.1
VSENS: C14.1, J4.2; also elsewhere on the board

Notes on the sheet:
MODULE DO AM DAT DIEN DUNG 'Capacitive Soil Moisture Sensor v1.2' J4 PH2.0-3P (cung loai cong tren module): 1=GND 2=VCC 3=AOUT. Nuoi tu VSENS 3.3V, chi bat khi do. Chon module dung TLC555 (NE555 khong chay o 3.3V). AOUT 0-3V (kho = cao) -> R12 1k -> IO1 (ADC1, ATTEN 12dB); C13 loc; D3 TVS chong ESD.

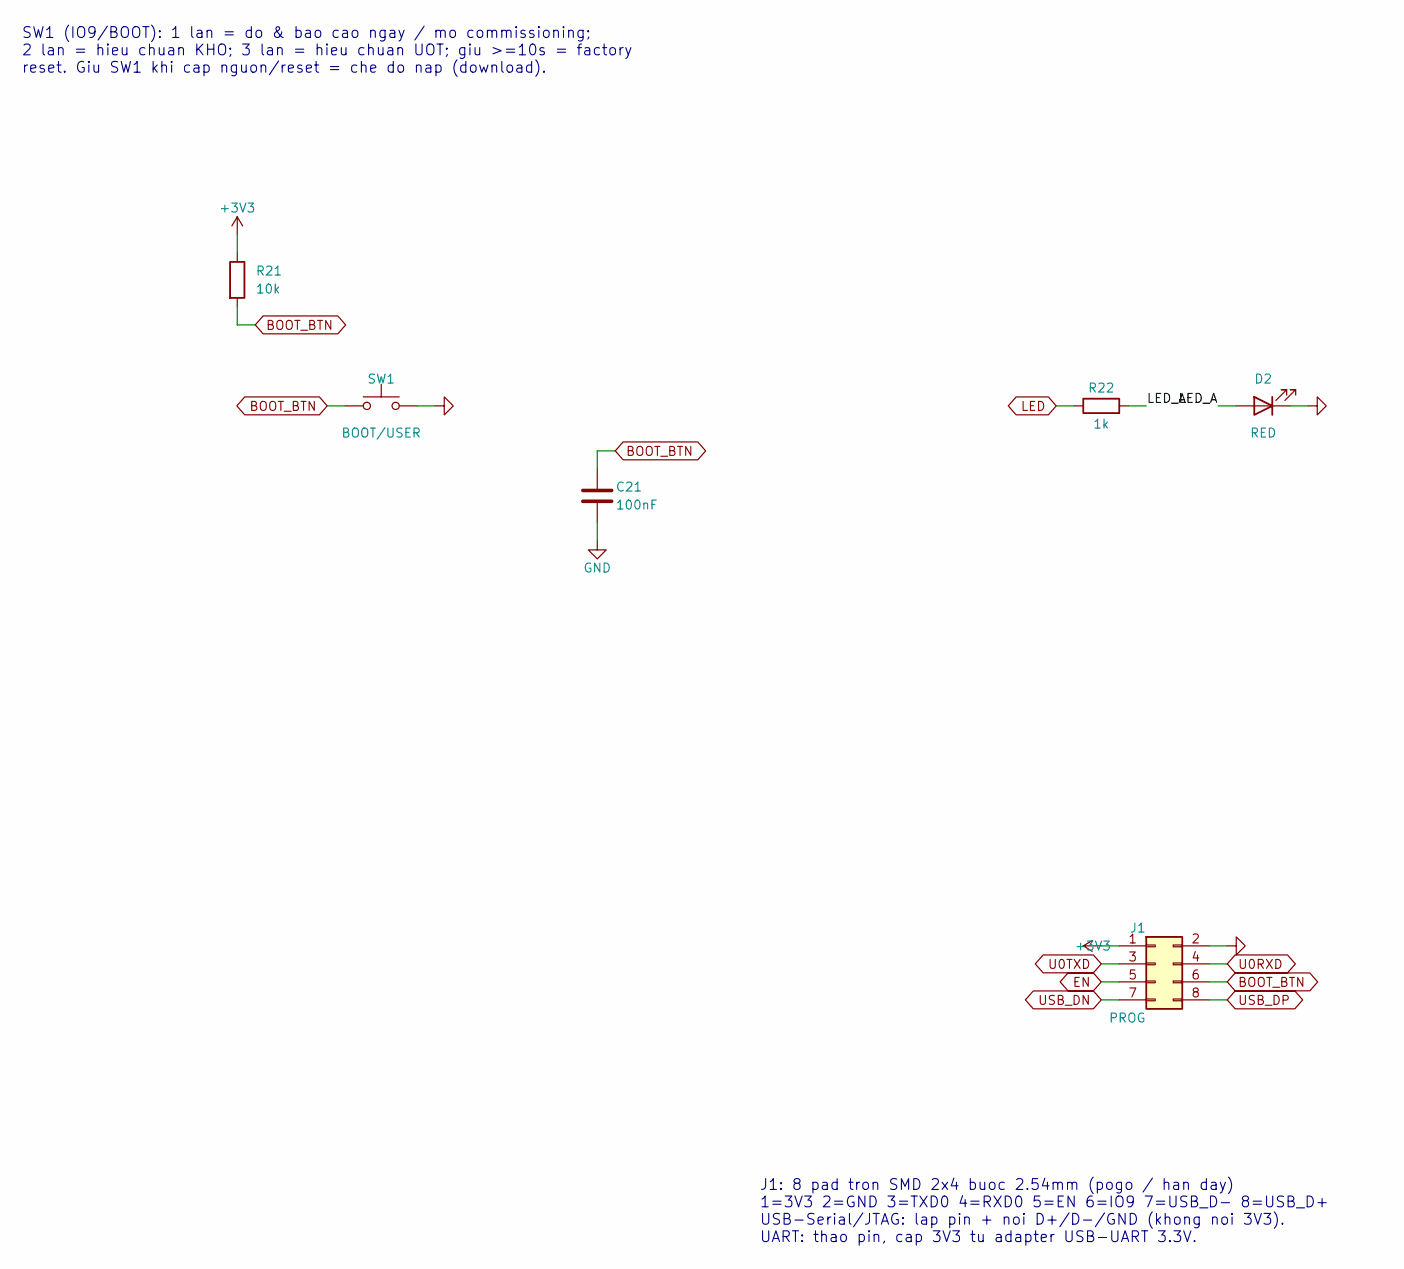
[picture p18: schematic ui.kicad_sch, UI: button, LED, programming pads]

Parts:
C21: 100nF; C_0603_1608Metric; MPN CC0603KRX7R9BB104; LCSC C14663
D2: RED; LED_0603_1608Metric; MPN KT-0603R; LCSC C2286
J1: PROG; ProgPads_2x04_P2.54mm_D1.5mm
R21: 10k; R_0603_1608Metric; MPN 0603WAF1002T5E; LCSC C25804
R22: 1k; R_0603_1608Metric; MPN 0603WAF1001T5E; LCSC C21190
SW1: BOOT/USER; SW_Push_1P1T_XKB_TS-1187A; MPN TS-1187A-B-A-B; LCSC C318884

Connections:
+3V3: J1.1, R21.1; also elsewhere on the board
BOOT_BTN: C21.1, J1.6, R21.2, SW1.1; also elsewhere on the board
EN: J1.5; also elsewhere on the board
GND: C21.2, D2.1 (K), J1.2, SW1.2; also elsewhere on the board
LED: R22.1; also elsewhere on the board
LED_A: D2.2 (A), R22.2
U0RXD: J1.4; also elsewhere on the board
U0TXD: J1.3; also elsewhere on the board
USB_DN: J1.7; also elsewhere on the board
USB_DP: J1.8; also elsewhere on the board

Notes on the sheet:
SW1 (IO9/BOOT): 1 lan = do & bao cao ngay / mo commissioning; 2 lan = hieu chuan KHO; 3 lan = hieu chuan UOT; giu >=10s = factory reset. Giu SW1 khi cap nguon/reset = che do nap (download).
J1: 8 pad tron SMD 2x4 buoc 2.54mm (pogo / han day) 1=3V3 2=GND 3=TXD0 4=RXD0 5=EN 6=IO9 7=USB_D- 8=USB_D+ USB-Serial/JTAG: lap pin + noi D+/D-/GND (khong noi 3V3). UART: thao pin, cap 3V3 tu adapter USB-UART 3.3V.

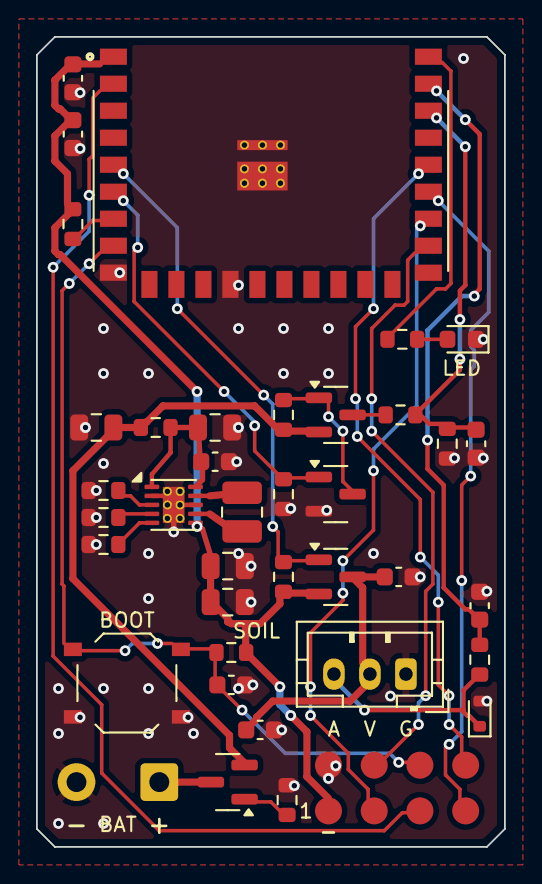
[picture p19: board h2-soil-sensor.kicad_pcb from above]

Board: 2 copper layers, 26.0 x 45.0 mm, 39 parts (0 on the bottom side), 28 nets.
