haxeko/h2-soil-sensor/firmware/main/app_openthread_config.h

/* OpenThread platform configuration: native 802.15.4 radio of the ESP32-H2. */
#pragma once

#if CHIP_DEVICE_CONFIG_ENABLE_THREAD
#include <platform/ESP32/OpenthreadLauncher.h>
#include "esp_openthread_types.h"

#define ESP_OPENTHREAD_DEFAULT_RADIO_CONFIG()                                           \
    {                                                                                   \
        .radio_mode = RADIO_MODE_NATIVE,                                                \
    }

#define ESP_OPENTHREAD_DEFAULT_HOST_CONFIG()                                            \
    {                                                                                   \
        .host_connection_mode = HOST_CONNECTION_MODE_NONE,                              \
    }

#define ESP_OPENTHREAD_DEFAULT_PORT_CONFIG()                                            \
    {                                                                                   \
        .storage_partition_name = "nvs",                                                \
        .netif_queue_size = 10,                                                         \
        .task_queue_size = 10,                                                          \
    }
#endif // CHIP_DEVICE_CONFIG_ENABLE_THREAD
