haxeko/h2-soil-sensor/(commit log)

2026-11-11 Add Matter-over-Thread battery soil moisture sensor (ESP32-H2)
    Hardware (KiCad 7+):
    - Hierarchical schematic (power, MCU, sensors, UI) generated from
    hardware/tools/design.py; netlist verified pin-by-pin against the design
    - CR123A + AO3415A reverse-polarity FET + TPS63900 buck-boost (3.3 V),
    zero-leakage switched battery divider and switched sensor rail (VSENS)
    - PCB-printed capacitive probe driven by TLC555I + peak detector,
    soil NTC on the stake, SHT40-AD1F, button/LED/programming header
    - 26 x 212 mm stake-shaped 2-layer PCB, antenna overhanging the top edge,
    fully routed (custom A* grid router), GND pours + stitching; DRC clean
    - Gerber/drill zip, JLCPCB BOM/CPL with verified LC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
    [h2-soil-sensor-B_Cu.gbl, h2-soil-sensor-B_Mask.gbs, h2-soil-sensor-B_Paste.gbp, h2-soil-sensor-B_Silkscreen.gbo, h2-soil-sensor-Edge_Cuts.gm1, h2-soil-sensor-F_Cu.gtl, h2-soil-sensor-F_Mask.gts, h2-soil-sensor-F_Paste.gtp]
2026-11-12 Hardware v2: ESP32-H2 + CR123A carrier board for off-the-shelf sensor modules
    - Remove PCB probe/TLC555/SHT40/battery holder; board is 36x60 mm with
    connectors: battery (JST-PH 2P + 2 solder pads), capacitive soil module
    (JST-PH 3P), NTC probe (JST-PH 2P), I2C T/RH module (1x4 2.54 mm)
    - Sensor lines protected by SRV05-4 (Semtech, C13612), VSENS load switch
    - Router: general board outline, mounting-hole keep-outs, deterministic order
    - New fpinfo.py (courtyard check) and render.py (illustrative renders)
    - Regenerated schematic, PCB (DRC 0 / unconnected 0), Gerbers, JLC BOM/CPL
    Claude-Session: https://claude.ai/code/session_01TvrXHT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
    [h2-soil-sensor-B_Cu.gbl, h2-soil-sensor-B_Mask.gbs, h2-soil-sensor-B_Paste.gbp, h2-soil-sensor-B_Silkscreen.gbo, h2-soil-sensor-Edge_Cuts.gm1, h2-soil-sensor-F_Cu.gtl, h2-soil-sensor-F_Mask.gts, h2-soil-sensor-F_Paste.gtp]
2026-11-12 Firmware v2: support off-the-shelf sensor modules
    - air_sensor.c replaces sht40.c: auto-detects AHT20 (0x38), SHT4x (0x44),
    SHT3x (0x44/0x45); Kconfig choice to force a type or disable it
    - Soil module AOUT on IO1 with 12 dB attenuation, defaults dry 2500 / wet
    1200 mV, 1.5 s settling spent in light sleep (power pins latched)
    - NTC probe on J7 with configurable R25/beta (default 10k / 3950)
    - NTC and air endpoints are created only for sensors found at boot
    - Remove TLC555/LEDC probe excitation options
    Claude-Session: https://claude.ai/code/session_01TvrXHTEMWDhKaBjmHa6QBV
    [app_main.cpp, app_matter.cpp, app_matter.h, board.c, board.h, sensors.c, sensors.h]
2026-11-12 Limit VSENS inrush: C14 1 uF and Q4 soft start
    - C14 on VSENS 10 uF -> 1 uF (modules carry their own decoupling)
    - board_sensor_power(): turn Q4 on through the weak internal pull-down
    first (CONFIG_VSENS_SOFTSTART_US, default 1 ms) so the module
    capacitors do not pull the +3V3 rail down
    - Regenerated schematic, PCB (identical routing, DRC 0/0), BOM/CPL
    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
    [h2-soil-sensor-B_Cu.gbl, h2-soil-sensor-B_Mask.gbs, h2-soil-sensor-B_Paste.gbp, h2-soil-sensor-B_Silkscreen.gbo, h2-soil-sensor-Edge_Cuts.gm1, h2-soil-sensor-F_Cu.gtl, h2-soil-sensor-F_Mask.gts, h2-soil-sensor-F_Paste.gtp]
2026-11-12 Docs v2: module-based carrier board; fab and build fixes
    - Rewrite README, hardware/firmware READMEs and docs 01-07 for v2
    (block diagram, schematic per block, BOM with LCSC codes, layout guide,
    power budget incl. sensor modules, firmware, outdoor risks)
    - power_budget.py: module currents; ~2.1 y (SIT) to ~2.7 y (LIT) on CR123A
    - make_fab: keep footprints with thermal-via pads in the CPL (U1 was missing)
    - Schematic title blocks rev 2.0; init air sensor locals (no build warnings)
    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
    [h2-soil-sensor-B_Cu.gbl, h2-soil-sensor-B_Mask.gbs, h2-soil-sensor-B_Paste.gbp, h2-soil-sensor-B_Silkscreen.gbo, h2-soil-sensor-Edge_Cuts.gm1, h2-soil-sensor-F_Cu.gtl, h2-soil-sensor-F_Mask.gts, h2-soil-sensor-F_Paste.gtp]
2026-11-12 Hardware v3: compact 26x45 mm board for the capacitive soil module only
    - Single sensor connector J4 (JST-PH 2.0 3P: GND VCC AOUT) for the
    'Capacitive Soil Moisture Sensor v1.2'; I2C/NTC connectors, pull-ups,
    SRV05-4, JST battery socket, test points, mounting holes and the
    optional 32 kHz crystal removed
    - ESD: one SOD-523 TVS on AOUT (LRC LESD5Z3.3T1G, C136161)
    - Programming header replaced by 8 round SMD pads (2x4, 2.54 mm, no paste)
    - Battery: two solder pads (+ square / - round) for the holder leads
    - Board 26x45 mm (was 36x60), DRC 0 / unconnected 0; fab files and renders
    Claude-Session: https://claude.ai/code/session_01TvrX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
    [h2-soil-sensor-B_Cu.gbl, h2-soil-sensor-B_Mask.gbs, h2-soil-sensor-B_Paste.gbp, h2-soil-sensor-B_Silkscreen.gbo, h2-soil-sensor-Edge_Cuts.gm1, h2-soil-sensor-F_Cu.gtl, h2-soil-sensor-F_Mask.gts, h2-soil-sensor-F_Paste.gtp]
2026-11-12 Firmware v3: soil module only
    - Remove the I2C air-sensor driver, NTC probe support, temperature
    compensation and the optional-endpoint logic (no such connectors on v3)
    - Matter: EP0 Root + Power Source, EP1 Soil Sensor, EP2 Humidity mirror
    - Unused module pins (IO3/4/12/13/14/22) parked as Hi-Z inputs
    - Build: 1.66 MB, 16 % free in the OTA slot, no warnings in app code
    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
2026-11-12 v3 docs; rotate J4 away from the programming pads
    - README, hardware/firmware READMEs, docs 01-07 and power_budget.py
    updated for the compact soil-only board (~2.2 y default battery life)
    - J4 rotated 180 deg so its housing faces away from the pogo pad rows
    (~3 mm clearance), silk labels 'A V G' under the connector
    - Sheet titles updated, unused sdkconfig.defaults.xtal32k removed (no
    crystal on v3), measurement comment fixed
    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
    [h2-soil-sensor-B_Cu.gbl, h2-soil-sensor-B_Mask.gbs, h2-soil-sensor-B_Paste.gbp, h2-soil-sensor-B_Silkscreen.gbo, h2-soil-sensor-Edge_Cuts.gm1, h2-soil-sensor-F_Cu.gtl, h2-soil-sensor-F_Mask.gts, h2-soil-sensor-F_Paste.gtp]
2026-11-12 Back silkscreen: board name, Design by Haxeko, Made in Vietnam
    - Remove the connector pinout lines from the bottom silkscreen
    - Regenerated PCB (DRC 0 / unconnected 0), Gerbers and renders; docs updated
    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
    [h2-soil-sensor-B_Cu.gbl, h2-soil-sensor-B_Mask.gbs, h2-soil-sensor-B_Paste.gbp, h2-soil-sensor-B_Silkscreen.gbo, h2-soil-sensor-Edge_Cuts.gm1, h2-soil-sensor-F_Cu.gtl, h2-soil-sensor-F_Mask.gts, h2-soil-sensor-F_Paste.gtp]
